TweetyDaBird/RefleXion-Grid/README.md

# RefleXion
 Ortho Split Keyboard

 -------------

This is a joint project with concept by 'The Reflex' (Pedro Quaresma), and design by 'TweetyDaBird' (Markus Knutsson).
