TweetyDaBird/RefleXion-Grid/RefleXion Grid - PCB/RefleXion Grid.kicad_pcb

## KiCad design RefleXion Grid - PCB/RefleXion Grid.kicad_pcb (2026-01-15)

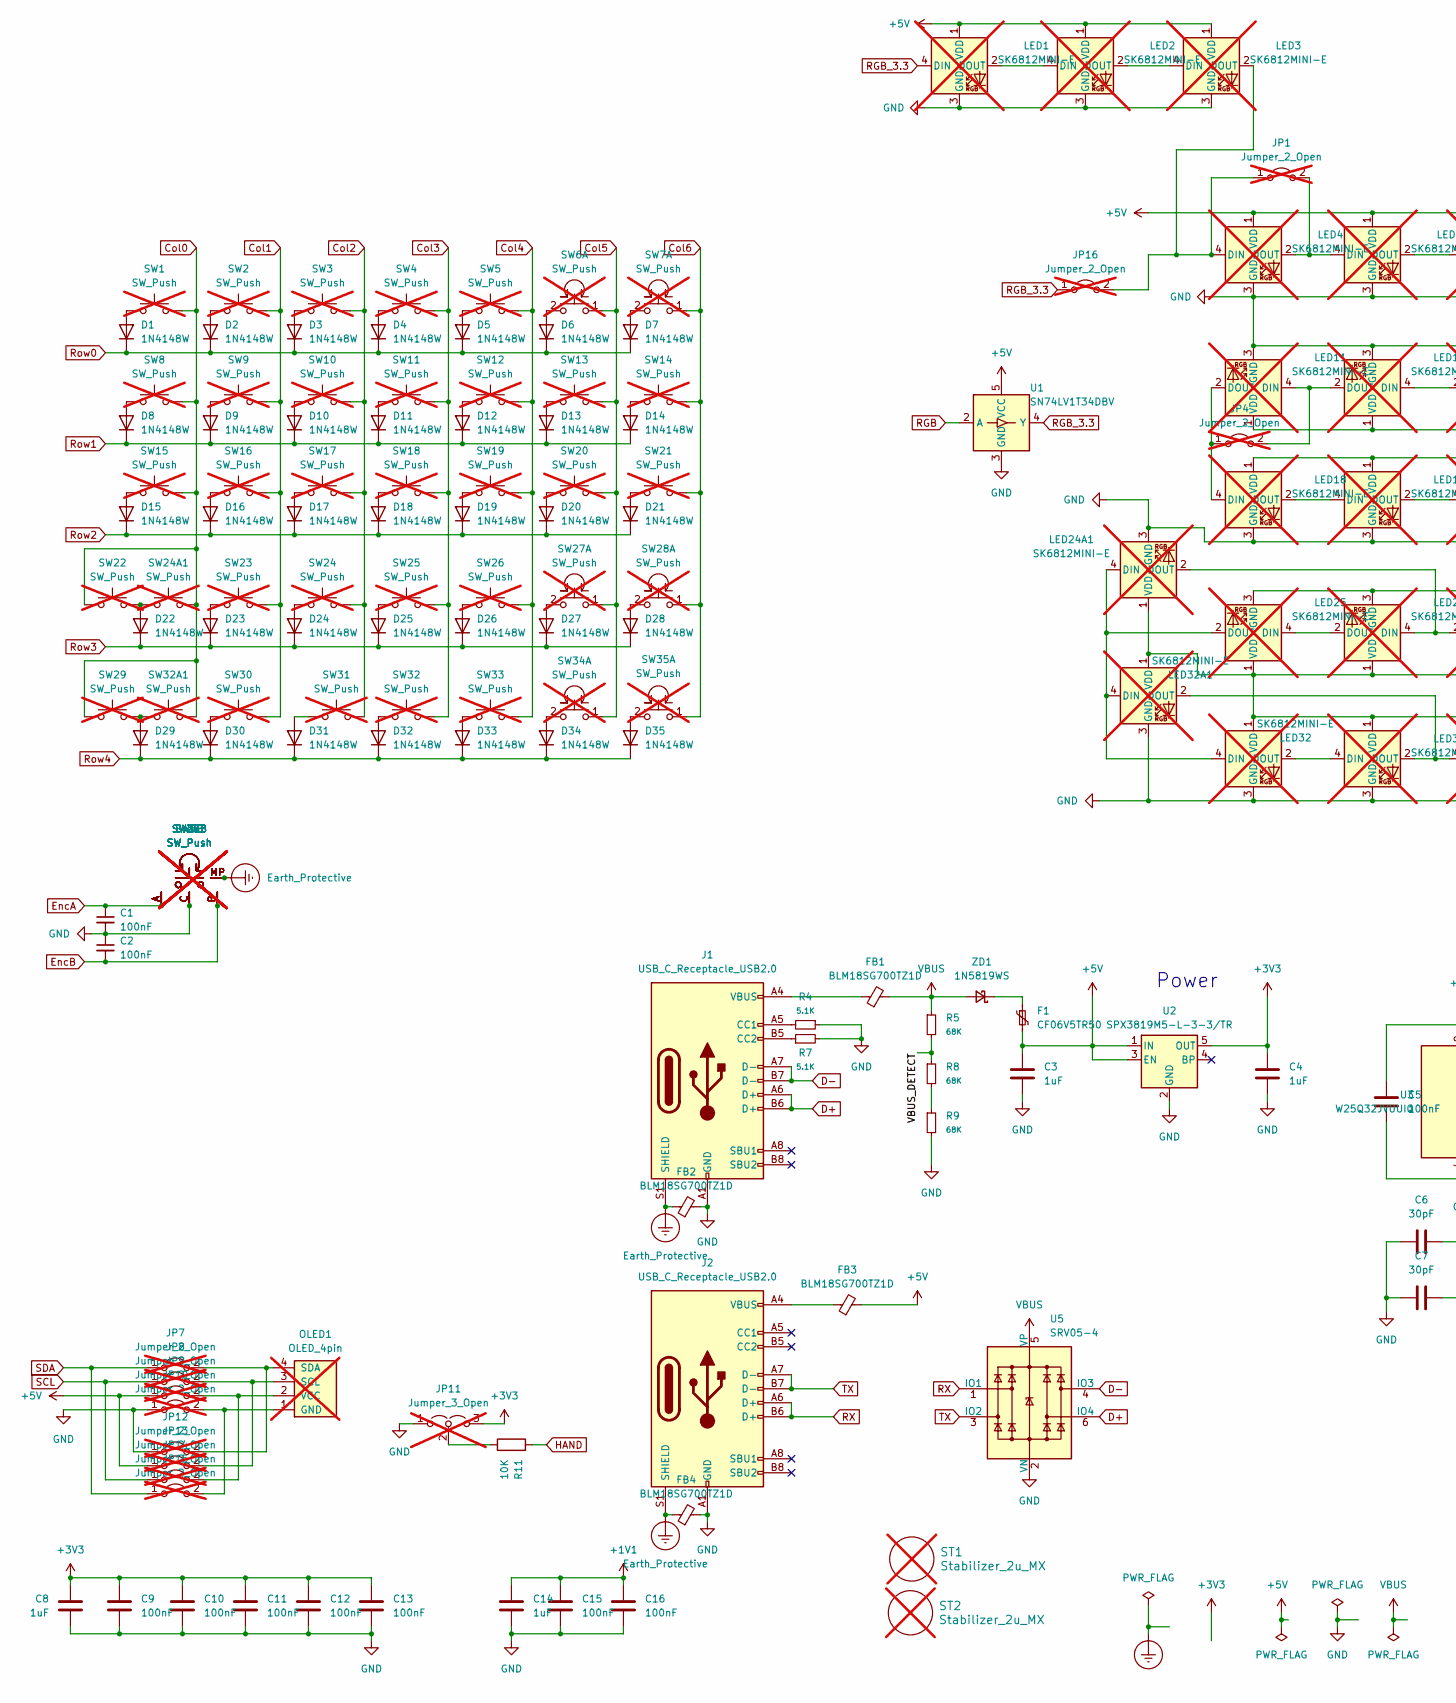
[picture p1: schematic RefleXion Grid.kicad_sch, RefleXion - Grid, part in row 1, column 1]

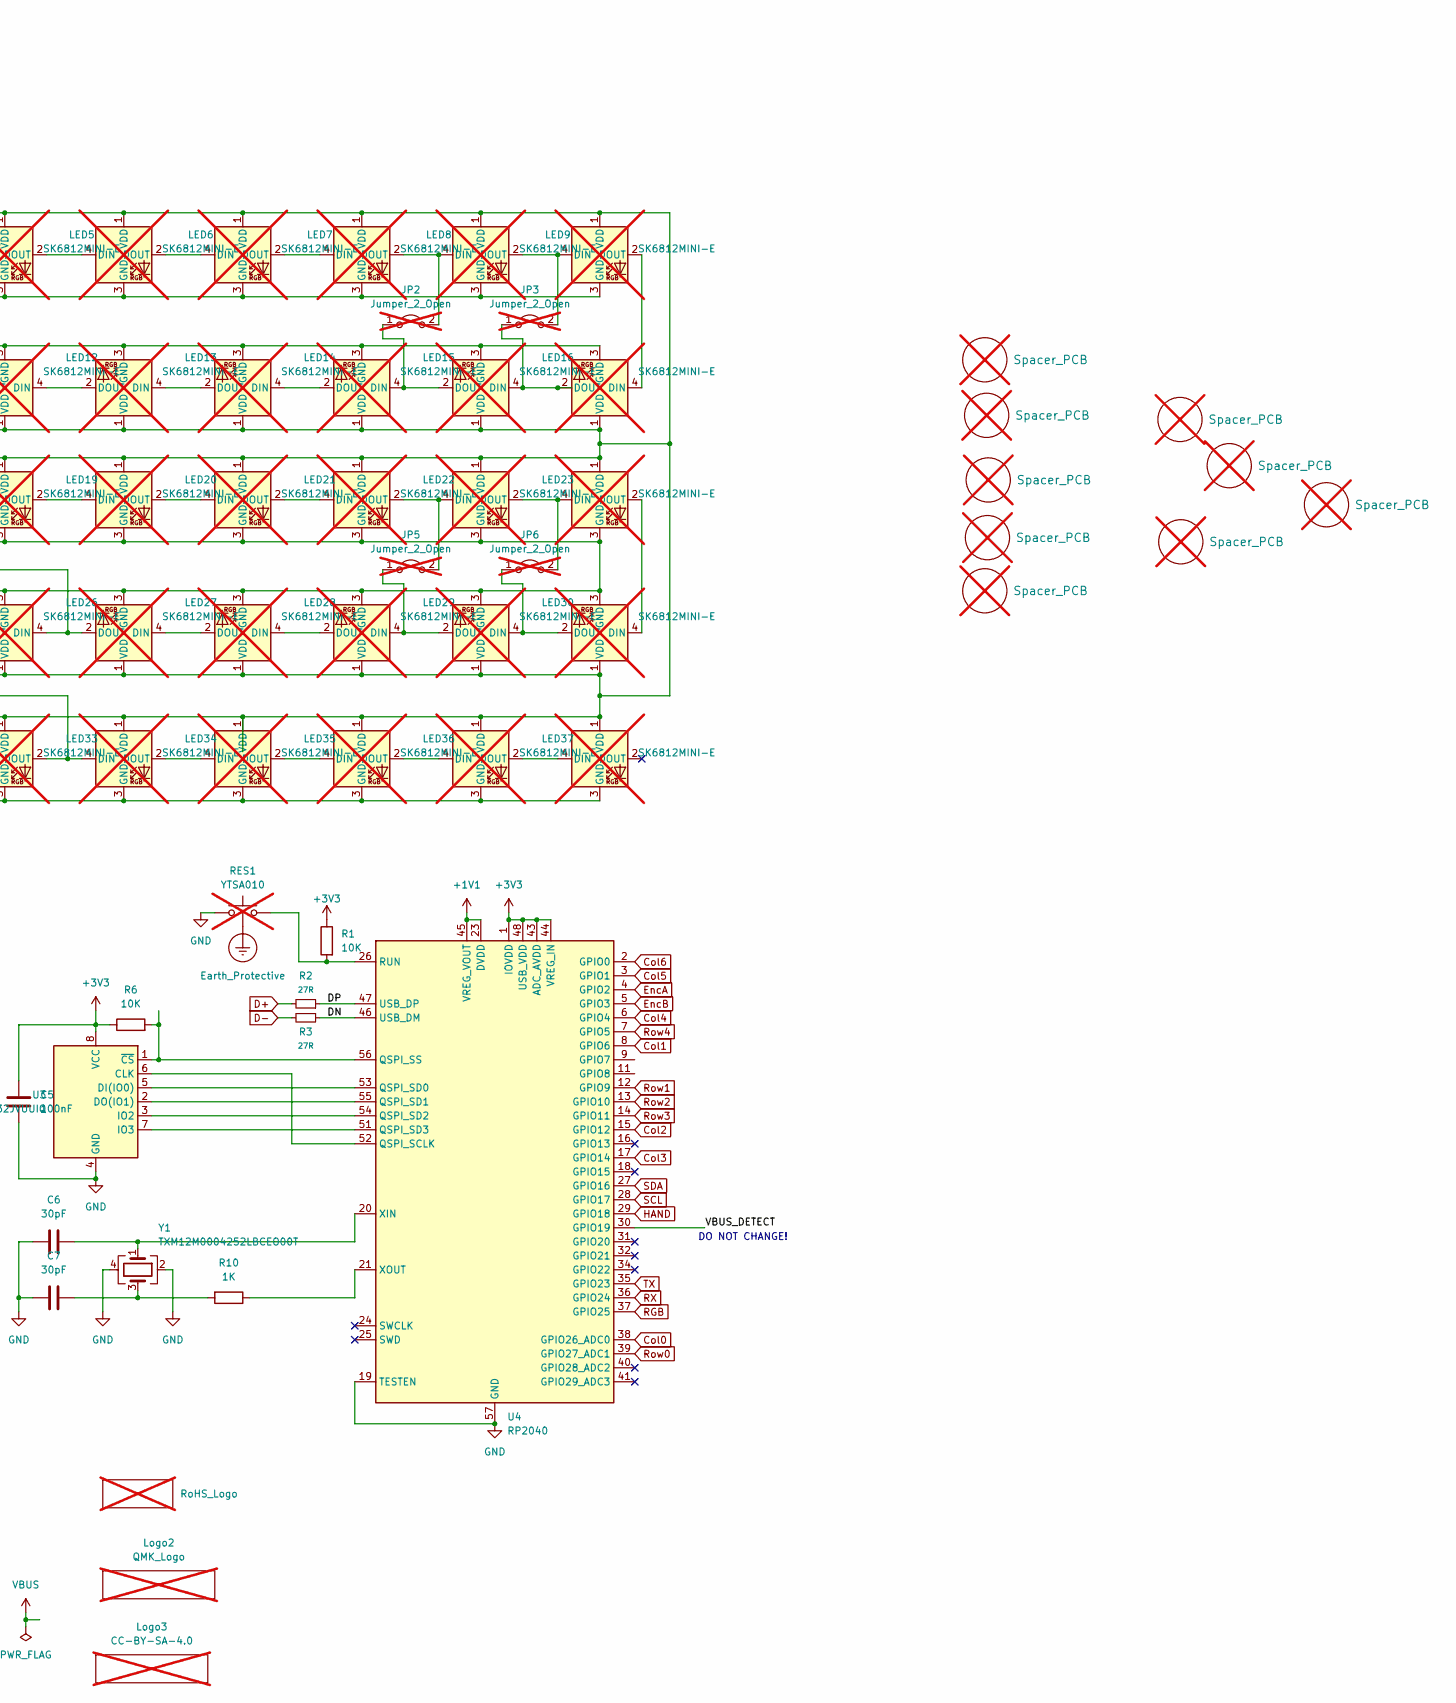
[picture p2: schematic RefleXion Grid.kicad_sch, RefleXion - Grid, part in row 1, column 2]

Parts:
C1, C2, C5, C9, C10, C11, C12, C13, C15, C16: 100nF; C_0402_1005Metric; LCSC C513772
C3, C4, C8, C14: 1uF; C_0402_1005Metric
C6, C7: 30pF; C_0402_1005Metric
D1, D2, D3, D4, D5, D6, D7, D8, D9, D10, D11, D12, D13, D14, D15, D16, D17, D18, D19, D20, D21, D22, D23, D24, D25, D26, D27, D28, D29, D30, D31, D32, D33, D34, D35: 1N4148W; D_SOD-123
F1: CF06V5TR50; R_0603_1608Metric; LCSC C163116
FB1, FB2, FB3, FB4: BLM18SG700TZ1D; C_0603_1608Metric_Pad1.08x0.95mm_HandSolder; LCSC C882974
H1, H2, H3, H4, H5, H6, H7, H8, H9: Spacer_PCB; Spacer PCB hole; not fitted
J1: USB_C_Receptacle_USB2.0; HRO_TYPE-C-31-M-12_double_sided; LCSC C165948
J2: USB_C_Receptacle_USB2.0; HRO_TYPE-C-31-M-12_double_sided_serial link; LCSC C165948
JP1, JP2, JP3, JP4, JP5, JP6, JP7, JP8, JP9, JP10, JP12, JP13, JP14, JP15, JP16: Jumper_2_Open; Jumper_min_v2; not fitted
JP11: Jumper_3_Open; SolderJumper-3_open_mini; not fitted
LED1, LED2, LED3, LED4, LED5, LED6, LED7, LED8, LED9, LED10, LED11, LED12, LED13, LED14, LED15, LED16, LED17, LED18, LED19, LED20, LED21, LED22, LED23, LED24, LED24A1, LED25, LED26, LED27, LED28, LED29, LED30, LED31, LED32, LED32A1, LED33, LED34, LED35, LED36, LED37, LED38: SK6812MINI-E; MX_SK6812MINI-E_REVERSIBLE_SMALL_PAD; not fitted
Logo1: RoHS_Logo; RoHs; not fitted
Logo2: QMK_Logo; Powered_by_QMK; not fitted
Logo3: CC-BY-SA-4.0; CC_BY_SA_40_line; not fitted
OLED1: OLED_4pin; OLED_SSD1306_128x32_0_91_inch; not fitted
R1, R6, R11: 10K; R_0402_1005Metric; LCSC C2078429
R2, R3: 27R; R_0402_1005Metric; LCSC C1701143
R4, R7: 5.1K; R_0402_1005Metric; LCSC C2075916
R5, R8, R9: 68K; R_0402_1005Metric; LCSC C2075916
R10: 1K; R_0402_1005Metric; LCSC C2139907
RES1: YTSA010; YTS-A002 Double-sided; LCSC C2888934; not fitted
ST1, ST2: Stabilizer_2u_MX; Stabilizer_Cherry_MX_2.00u; not fitted
SW1, SW2, SW3, SW4, SW5, SW8, SW9, SW10, SW11, SW12, SW13, SW14, SW15, SW16, SW17, SW18, SW19, SW20, SW21, SW22, SW23, SW24, SW24A1, SW25, SW26, SW29, SW30, SW31, SW32, SW32A1, SW33: SW_Push; SW_MX_HotSwap_Reversible; not fitted
SW6, SW7, SW27, SW28, SW34, SW35: SW_Push; SW_MX_HotSwap_Reversible_Encoder; not fitted
U1: SN74LV1T34DBV; SOT-23-5; LCSC C100024
U2: SPX3819M5-L-3-3/TR; SOT-23-5; LCSC C9055
U3: W25Q32JVUUIQ; USON-8_4x3mm_P0.8mm; LCSC C2999380
U4: RP2040; QFN-56-1EP_7x7mm_P0.4mm_EP3.2x3.2mm_ThermalVias; LCSC C2040
U5: SRV05-4; SOT-23-6; LCSC C558418
Y1: TXM12M0004252LBCEO00T; Crystal_SMD_2520-4Pin_2.5x2.0mm; PartNo C284156; LCSC C284156
ZD1: 1N5819WS; D_SOD-323F

Connections:
+1V1: C14.1, C15.1, C16.1, U4.23 (DVDD), U4.45 (VREG_VOUT), U4.50 (DVDD)
+3V3: C4.1, C5.1, C8.1, C9.1, C10.1, C11.1, C12.1, C13.1, JP11.3 (B), R1.1, R6.1, U2.5 (OUT), U3.8 (VCC), U4.1 (IOVDD), U4.10 (IOVDD), U4.22 (IOVDD), U4.33 (IOVDD), U4.42 (IOVDD), U4.43 (ADC_AVDD), U4.44 (VREG_IN), U4.48 (USB_VDD), U4.49 (IOVDD)
+5V: C3.1, F1.2, FB3.2, JP9.1 (A), JP13.1 (A), LED1.1 (VDD), LED2.1 (VDD), LED3.1 (VDD), LED4.1 (VDD), LED5.1 (VDD), LED6.1 (VDD), LED7.1 (VDD), LED8.1 (VDD), LED9.1 (VDD), LED10.1 (VDD), LED11.1 (VDD), LED12.1 (VDD), LED13.1 (VDD), LED14.1 (VDD), LED15.1 (VDD), LED16.1 (VDD), LED17.1 (VDD), LED18.1 (VDD), LED19.1 (VDD), LED20.1 (VDD), LED21.1 (VDD), LED22.1 (VDD), LED23.1 (VDD), LED24.1 (VDD), LED24A1.1 (VDD), LED25.1 (VDD), LED26.1 (VDD), LED27.1 (VDD), LED28.1 (VDD), LED29.1 (VDD), LED30.1 (VDD), LED31.1 (VDD), LED32.1 (VDD), LED32A1.1 (VDD), LED33.1 (VDD), LED34.1 (VDD), LED35.1 (VDD), LED36.1 (VDD), LED37.1 (VDD), LED38.1 (VDD), U1.5 (VCC), U2.1 (IN), U2.3 (EN)
/DN: R3.1, U4.46 (USB_DM)
/DP: R2.1, U4.47 (USB_DP)
/VBUS_DETECT: R5.2, R8.1, U4.30 (GPIO19)
Col0: SW1.1, SW8.1, SW15.1, SW22.1, SW24A1.1, SW29.1, SW32A1.1, U4.38 (GPIO26_ADC0)
Col1: SW2.2, SW9.2, SW16.2, SW23.2, SW30.2, U4.8 (GPIO6)
Col2: SW3.2, SW10.2, SW17.2, SW24.2, SW31.2, U4.15 (GPIO12)
Col3: SW4.2, SW11.2, SW18.2, SW25.2, SW32.2, U4.17 (GPIO14)
Col4: SW5.2, SW12.2, SW19.2, SW26.2, SW33.2, U4.6 (GPIO4)
Col5: SW6.1, SW13.1, SW20.1, SW27.1, SW34.1, U4.3 (GPIO1)
Col6: SW7.1, SW14.1, SW21.1, SW28.1, SW35.1, U4.2 (GPIO0)
D+: J1.A6 (D+), J1.B6 (D+), R2.2, U5.6 (IO4)
D-: J1.A7 (D-), J1.B7 (D-), R3.2, U5.4 (IO3)
Earth_Protective: FB2.1, FB4.1, J1.S1 (SHIELD), J2.S1 (SHIELD), RES1.3, SW6.MP, SW7.MP, SW27.MP, SW28.MP, SW34.MP, SW35.MP
EncA: C1.1, SW6.A, SW7.A, SW27.A, SW28.A, SW34.A, SW35.A, U4.4 (GPIO2)
EncB: C2.2, SW6.B, SW7.B, SW27.B, SW28.B, SW34.B, SW35.B, U4.5 (GPIO3)
GND: C1.2, C2.1, C3.2, C4.2, C5.2, C6.2, C7.2, C8.2, C9.2, C10.2, C11.2, C12.2, C13.2, C14.2, C15.2, C16.2, FB2.2, FB4.2, J1.A1 (GND), J1.A12 (GND), J1.B1 (GND), J1.B12 (GND), J2.A1 (GND), J2.A12 (GND), J2.B1 (GND), J2.B12 (GND), JP10.1 (A), JP11.1 (A), JP12.1 (A), LED1.3 (GND), LED2.3 (GND), LED3.3 (GND), LED4.3 (GND), LED5.3 (GND), LED6.3 (GND), LED7.3 (GND), LED8.3 (GND), LED9.3 (GND), LED10.3 (GND), LED11.3 (GND), LED12.3 (GND), LED13.3 (GND), LED14.3 (GND), LED15.3 (GND), LED16.3 (GND), LED17.3 (GND), LED18.3 (GND), LED19.3 (GND), LED20.3 (GND), LED21.3 (GND), LED22.3 (GND), LED23.3 (GND), LED24.3 (GND), LED24A1.3 (GND), LED25.3 (GND), LED26.3 (GND), LED27.3 (GND), LED28.3 (GND), LED29.3 (GND), LED30.3 (GND), LED31.3 (GND), LED32.3 (GND), LED32A1.3 (GND), LED33.3 (GND), LED34.3 (GND), LED35.3 (GND), LED36.3 (GND), LED37.3 (GND), LED38.3 (GND), R4.1, R7.2, R9.2, RES1.1, SW6.C, SW7.C, SW27.C, SW28.C, SW34.C, SW35.C, U1.3 (GND), U2.2 (GND), U3.4 (GND), U4.19 (TESTEN), U4.57 (GND), U5.2 (VN), Y1.2, Y1.4
HAND: R11.2, U4.29 (GPIO18)
unnamed: C7.1, R10.2, Y1.3
unnamed: D1.2 (A), SW1.2
unnamed: D2.2 (A), SW2.1
unnamed: D3.2 (A), SW3.1
unnamed: D4.2 (A), SW4.1
unnamed: D5.2 (A), SW5.1
unnamed: D6.2 (A), SW6.2
unnamed: D7.2 (A), SW7.2
unnamed: D8.2 (A), SW8.2
unnamed: D9.2 (A), SW9.1
unnamed: D10.2 (A), SW10.1
unnamed: D11.2 (A), SW11.1
unnamed: D12.2 (A), SW12.1
unnamed: D13.2 (A), SW13.2
unnamed: D14.2 (A), SW14.2
unnamed: D15.2 (A), SW15.2
unnamed: D16.2 (A), SW16.1
unnamed: D17.2 (A), SW17.1
unnamed: D18.2 (A), SW18.1
unnamed: D19.2 (A), SW19.1
unnamed: D20.2 (A), SW20.2
unnamed: D21.2 (A), SW21.2
unnamed: D22.2 (A), SW22.2, SW24A1.2
unnamed: D23.2 (A), SW23.1
unnamed: D24.2 (A), SW24.1
unnamed: D25.2 (A), SW25.1
unnamed: D26.2 (A), SW26.1
unnamed: D27.2 (A), SW27.2
unnamed: D28.2 (A), SW28.2
unnamed: D29.2 (A), SW29.2, SW32A1.2
unnamed: D30.2 (A), SW30.1
unnamed: D31.2 (A), SW31.1
unnamed: D32.2 (A), SW32.1
unnamed: D33.2 (A), SW33.1
unnamed: D34.2 (A), SW34.2
unnamed: D35.2 (A), SW35.2
unnamed: FB1.1, J1.A4 (VBUS), J1.A9 (VBUS), J1.B4 (VBUS), J1.B9 (VBUS)
unnamed: FB3.1, J2.A4 (VBUS), J2.A9 (VBUS), J2.B4 (VBUS), J2.B9 (VBUS)
unnamed: J1.A5 (CC1), R4.2
unnamed: J1.B5 (CC2), R7.1
unnamed: JP1.1 (A), JP16.2 (B), LED3.2 (DOUT), LED4.4 (DIN)
unnamed: JP1.2 (B), LED4.2 (DOUT), LED5.4 (DIN)
unnamed: JP2.1 (A), LED15.4 (DIN), LED16.2 (DOUT)
unnamed: JP2.2 (B), LED8.2 (DOUT), LED9.4 (DIN)
unnamed: JP3.1 (A), LED16.4 (DIN), LED17.2 (DOUT)
unnamed: JP3.2 (B), LED9.2 (DOUT), LED10.4 (DIN)
unnamed: JP4.1 (A), LED11.2 (DOUT), LED18.4 (DIN)
unnamed: JP4.2 (B), LED11.4 (DIN), LED12.2 (DOUT)
unnamed: JP5.1 (A), LED29.4 (DIN), LED30.2 (DOUT)
unnamed: JP5.2 (B), LED22.2 (DOUT), LED23.4 (DIN)
unnamed: JP6.1 (A), LED30.4 (DIN), LED31.2 (DOUT)
unnamed: JP6.2 (B), LED23.2 (DOUT), LED24.4 (DIN)
unnamed: JP10.2 (B), JP15.2 (B), OLED1.1 (GND)
unnamed: JP11.2 (C), R11.1
unnamed: JP7.2 (B), JP12.2 (B), OLED1.4 (SDA)
unnamed: JP8.2 (B), JP13.2 (B), OLED1.3 (SCL)
unnamed: JP9.2 (B), JP14.2 (B), OLED1.2 (VCC)
unnamed: LED1.2 (DOUT), LED2.4 (DIN)
unnamed: LED2.2 (DOUT), LED3.4 (DIN)
unnamed: LED5.2 (DOUT), LED6.4 (DIN)
unnamed: LED6.2 (DOUT), LED7.4 (DIN)
unnamed: LED7.2 (DOUT), LED8.4 (DIN)
unnamed: LED10.2 (DOUT), LED17.4 (DIN)
unnamed: LED12.4 (DIN), LED13.2 (DOUT)
unnamed: LED13.4 (DIN), LED14.2 (DOUT)
unnamed: LED14.4 (DIN), LED15.2 (DOUT)
unnamed: LED18.2 (DOUT), LED19.4 (DIN)
unnamed: LED19.2 (DOUT), LED20.4 (DIN)
unnamed: LED20.2 (DOUT), LED21.4 (DIN)
unnamed: LED21.2 (DOUT), LED22.4 (DIN)
unnamed: LED24.2 (DOUT), LED31.4 (DIN)
unnamed: LED24A1.4 (DIN), LED25.2 (DOUT), LED32.4 (DIN), LED32A1.4 (DIN)
unnamed: LED24A1.2 (DOUT), LED26.4 (DIN), LED27.2 (DOUT)
unnamed: LED25.4 (DIN), LED26.2 (DOUT)
unnamed: LED27.4 (DIN), LED28.2 (DOUT)
unnamed: LED28.4 (DIN), LED29.2 (DOUT)
unnamed: LED32.2 (DOUT), LED33.4 (DIN)
unnamed: LED32A1.2 (DOUT), LED33.2 (DOUT), LED34.4 (DIN)
unnamed: LED34.2 (DOUT), LED35.4 (DIN)
unnamed: LED35.2 (DOUT), LED36.4 (DIN)
unnamed: LED36.2 (DOUT), LED37.4 (DIN)
unnamed: LED37.2 (DOUT), LED38.4 (DIN)
unnamed: R8.2, R9.1
unnamed: U3.6 (CLK), U4.52 (QSPI_SCLK)
unnamed: U3.5 (DI(IO0)), U4.53 (QSPI_SD0)
unnamed: U3.2 (DO(IO1)), U4.55 (QSPI_SD1)
unnamed: U3.3 (IO2), U4.54 (QSPI_SD2)
unnamed: U3.7 (IO3), U4.51 (QSPI_SD3)
unnamed: R6.2, U3.1 (~CS), U4.56 (QSPI_SS)
unnamed: R1.2, RES1.2, U4.26 (RUN)
unnamed: C6.1, U4.20 (XIN), Y1.1
unnamed: R10.1, U4.21 (XOUT)
unnamed: F1.1, ZD1.1 (K)
RGB: U1.2 (A), U4.37 (GPIO25)
RGB_3.3: JP16.1 (A), LED1.4 (DIN), U1.4 (Y)
RX: J2.A6 (D+), J2.B6 (D+), U4.36 (GPIO24), U5.1 (IO1)
Row0: D1.1 (K), D2.1 (K), D3.1 (K), D4.1 (K), D5.1 (K), D6.1 (K), D7.1 (K), U4.39 (GPIO27_ADC1)
Row1: D8.1 (K), D9.1 (K), D10.1 (K), D11.1 (K), D12.1 (K), D13.1 (K), D14.1 (K), U4.12 (GPIO9)
Row2: D15.1 (K), D16.1 (K), D17.1 (K), D18.1 (K), D19.1 (K), D20.1 (K), D21.1 (K), U4.13 (GPIO10)
Row3: D22.1 (K), D23.1 (K), D24.1 (K), D25.1 (K), D26.1 (K), D27.1 (K), D28.1 (K), U4.14 (GPIO11)
Row4: D29.1 (K), D30.1 (K), D31.1 (K), D32.1 (K), D33.1 (K), D34.1 (K), D35.1 (K), U4.7 (GPIO5)
SCL: JP8.1 (A), JP14.1 (A), U4.28 (GPIO17)
SDA: JP7.1 (A), JP15.1 (A), U4.27 (GPIO16)
TX: J2.A7 (D-), J2.B7 (D-), U4.35 (GPIO23), U5.3 (IO2)
VBUS: FB1.2, R5.1, U5.5 (VP), ZD1.2 (A)

Notes on the sheet:
Power
DO NOT CHANGE!

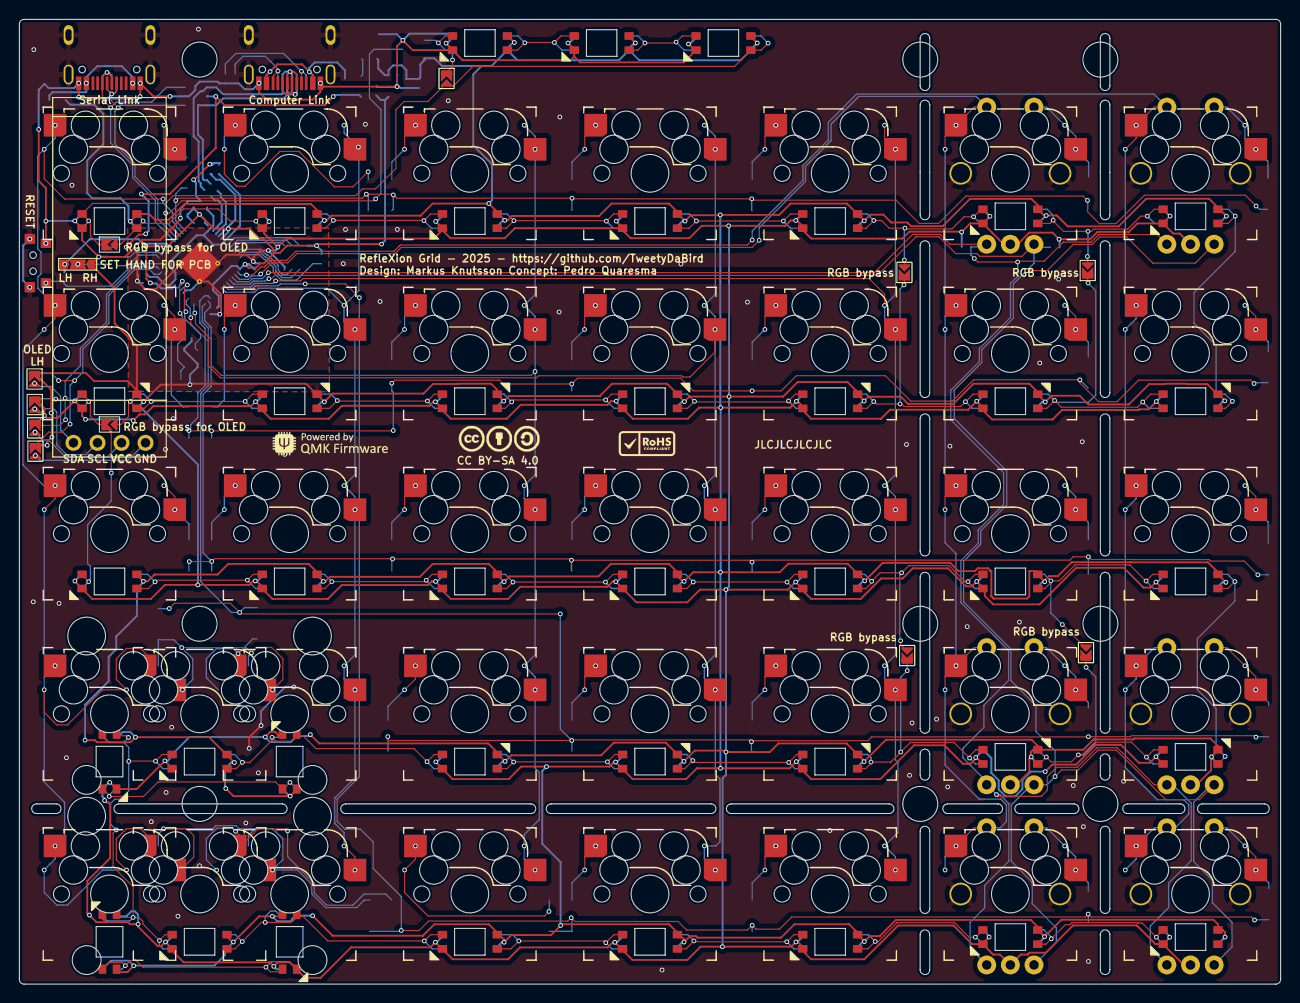
[picture p3: board RefleXion Grid.kicad_pcb from above]

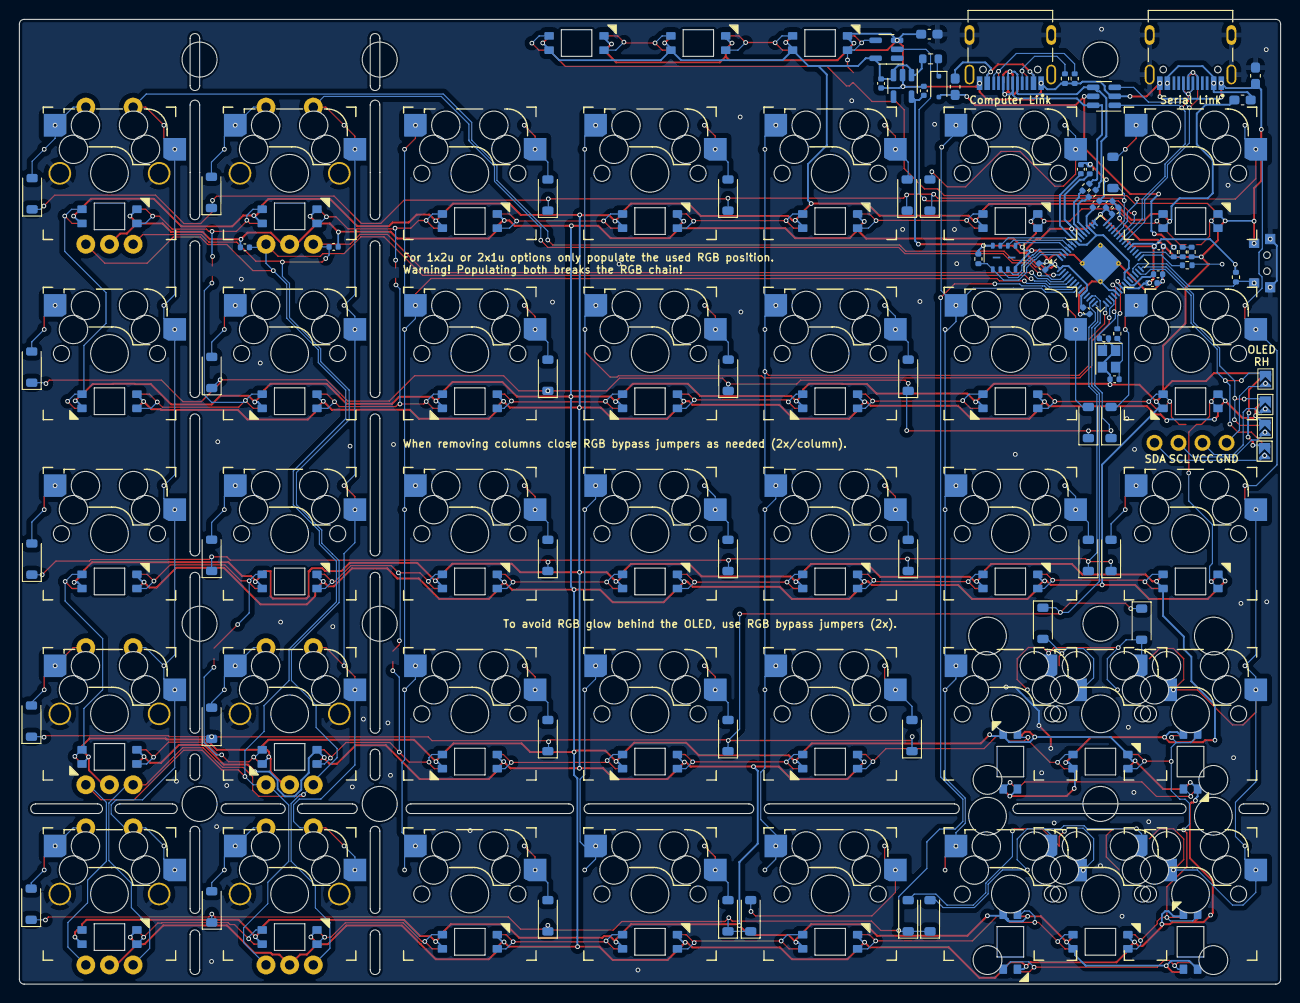
[picture p4: board RefleXion Grid.kicad_pcb from below]

Board: 2 copper layers, 133.4 x 102.0 mm, 185 parts (82 on the bottom side), 125 nets.
