TweetyDaBird/RefleXion-Grid/(notices)

Notices in the files:
RefleXion Grid - PCB/RefleXion Grid.kicad_sch:
Licensed under Creative Commons BY-SA 4.0 International
